SISTEAMNANCY/ROne/README.md

# ROne
Automated manual resuscitator prototype. To study the constraints , before thinking a use on a patient.
Prototype d'insufflateur "BAVU" automatisé. Pour étude des contraintes avant d'envisager une utilisation sur patient.
03/07/2020 : Le code du microcontrôleur de sécurité n'est pas commenté. Le bouton de silence alarme n'est pas encore  fonctionnel. Après modification d'un réglage de FR, I:E ou Vt, il faudrait invalider les alarmes jusqu'au cycle suivant pour éviter une alarme intempestive de débranchement patient.
