SISTEAMNANCY/ROne/ROne_logigramme_général.pdf

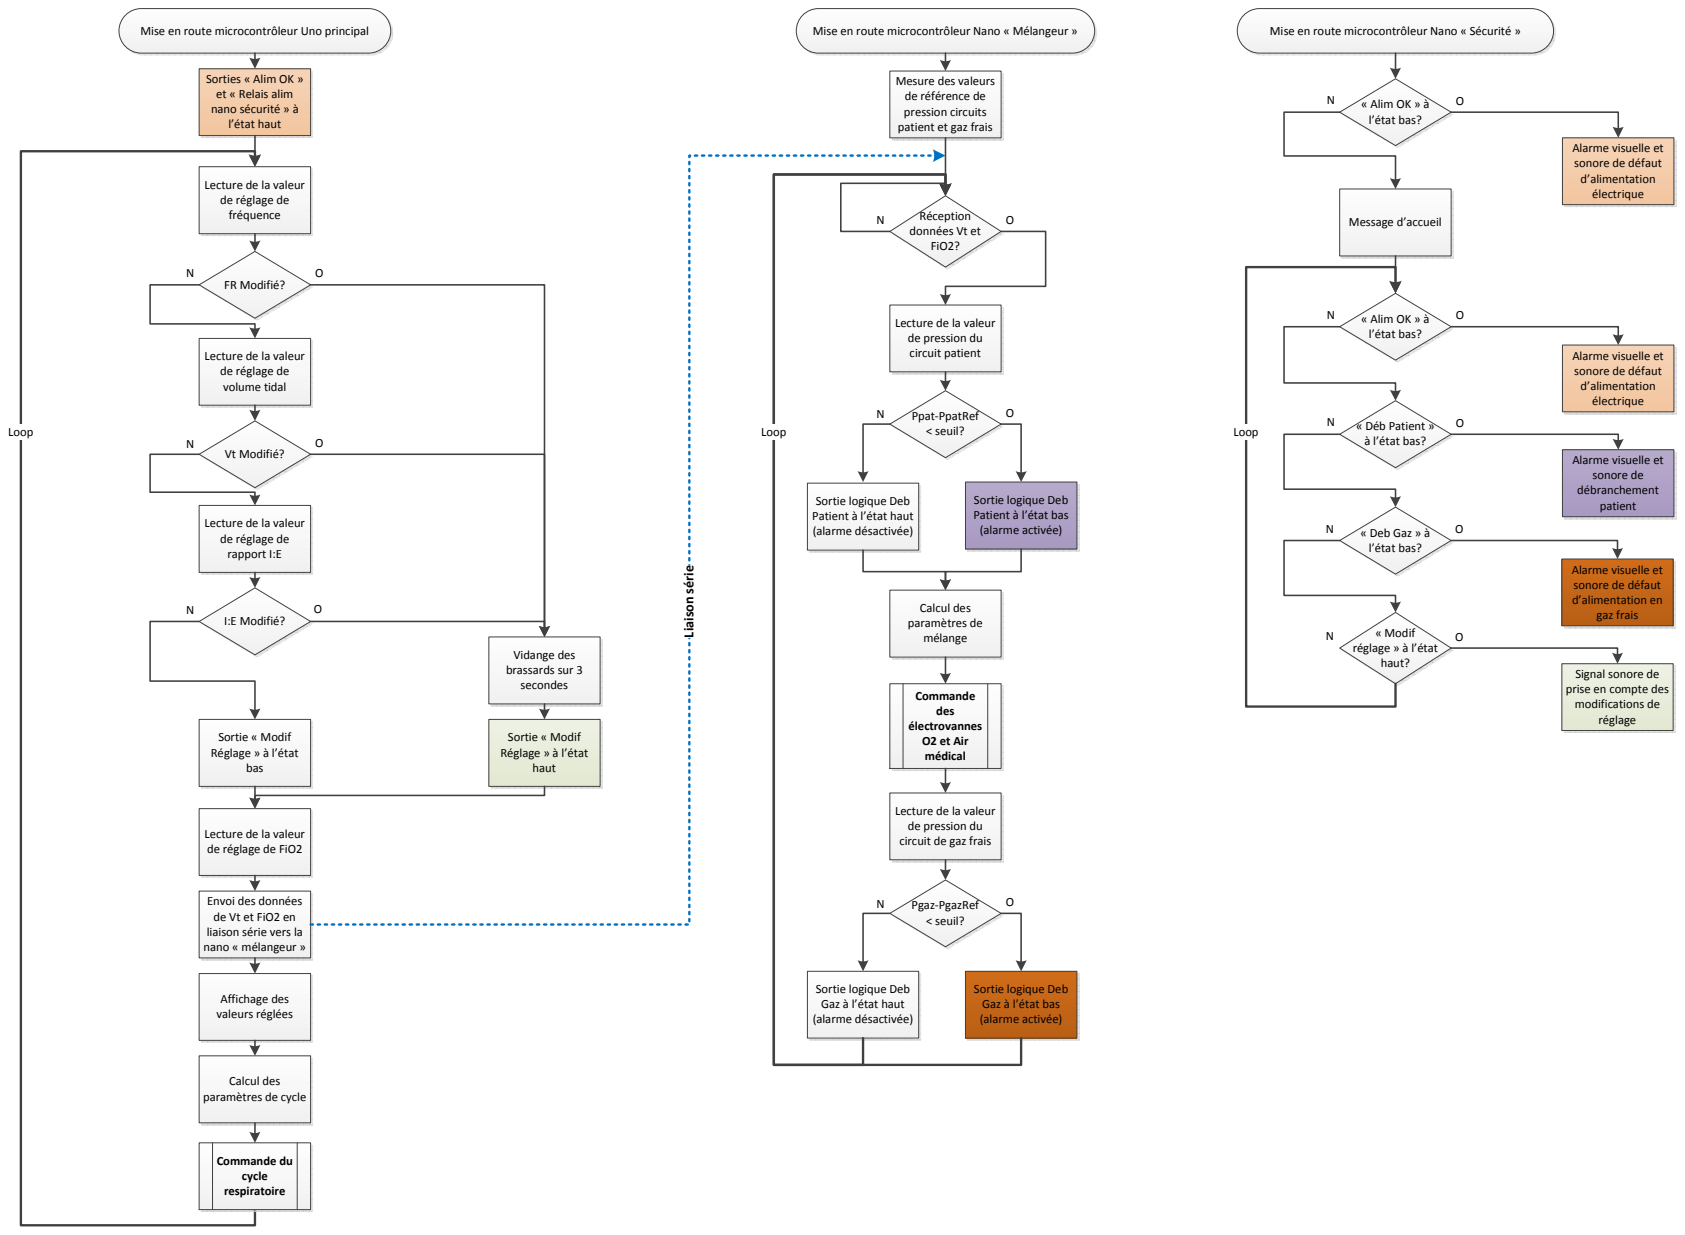
[picture p3: page 1]
FR Modifié?; Vt Modifié?; I:E Modifié?; Vidange des brassards sur 3 secondes; Affichage des valeurs réglées; Loop; Sortie « Modif Réglage » à l’état haut; Sortie « Modif Réglage » à l’état bas; Réception données Vt et FiO2?; Ppat-PpatRef < seuil?; Calcul des paramètres de mélange; Pgaz-PgazRef < seuil?; Message d’accueil; « Alim OK » à l’état bas?; « Déb Patient » à l’état bas?; « Deb Gaz » à l’état bas?; « Modif réglage » à l’état haut?; Liaison série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

Mise en route microcontrôleur Uno principal

Mise en route microcontrôleur Nano « Mélangeur »

Mise en route microcontrôleur Nano « Sécurité »

Sorties « Alim OK »
et « Relais alim
nano sécurité » à
l’état haut

Mesure des valeurs
de référence de
pression circuits
patient et gaz frais

Alarme visuelle et
sonore de défaut
d’alimentation
électrique

Lecture de la valeur
de réglage de
fréquence

de pression du
circuit patient

volume tidal

sonore de
débranchement
patient

Sortie logique Deb
Patient à l’état haut
(alarme désactivée)

Patient à l’état bas
(alarme activée)

rapport I:E

d’alimentation en
gaz frais

Signal sonore de
prise en compte des
modifications de
réglage

circuit de gaz frais

de réglage de FiO2

Envoi des données
de Vt et FiO2 en
liaison série vers la
nano « mélangeur »

Gaz à l’état haut

Gaz à l’état bas

Calcul des
paramètres de cycle
