SISTEAMNANCY/ROne/ROne_plan_berceau.PDF

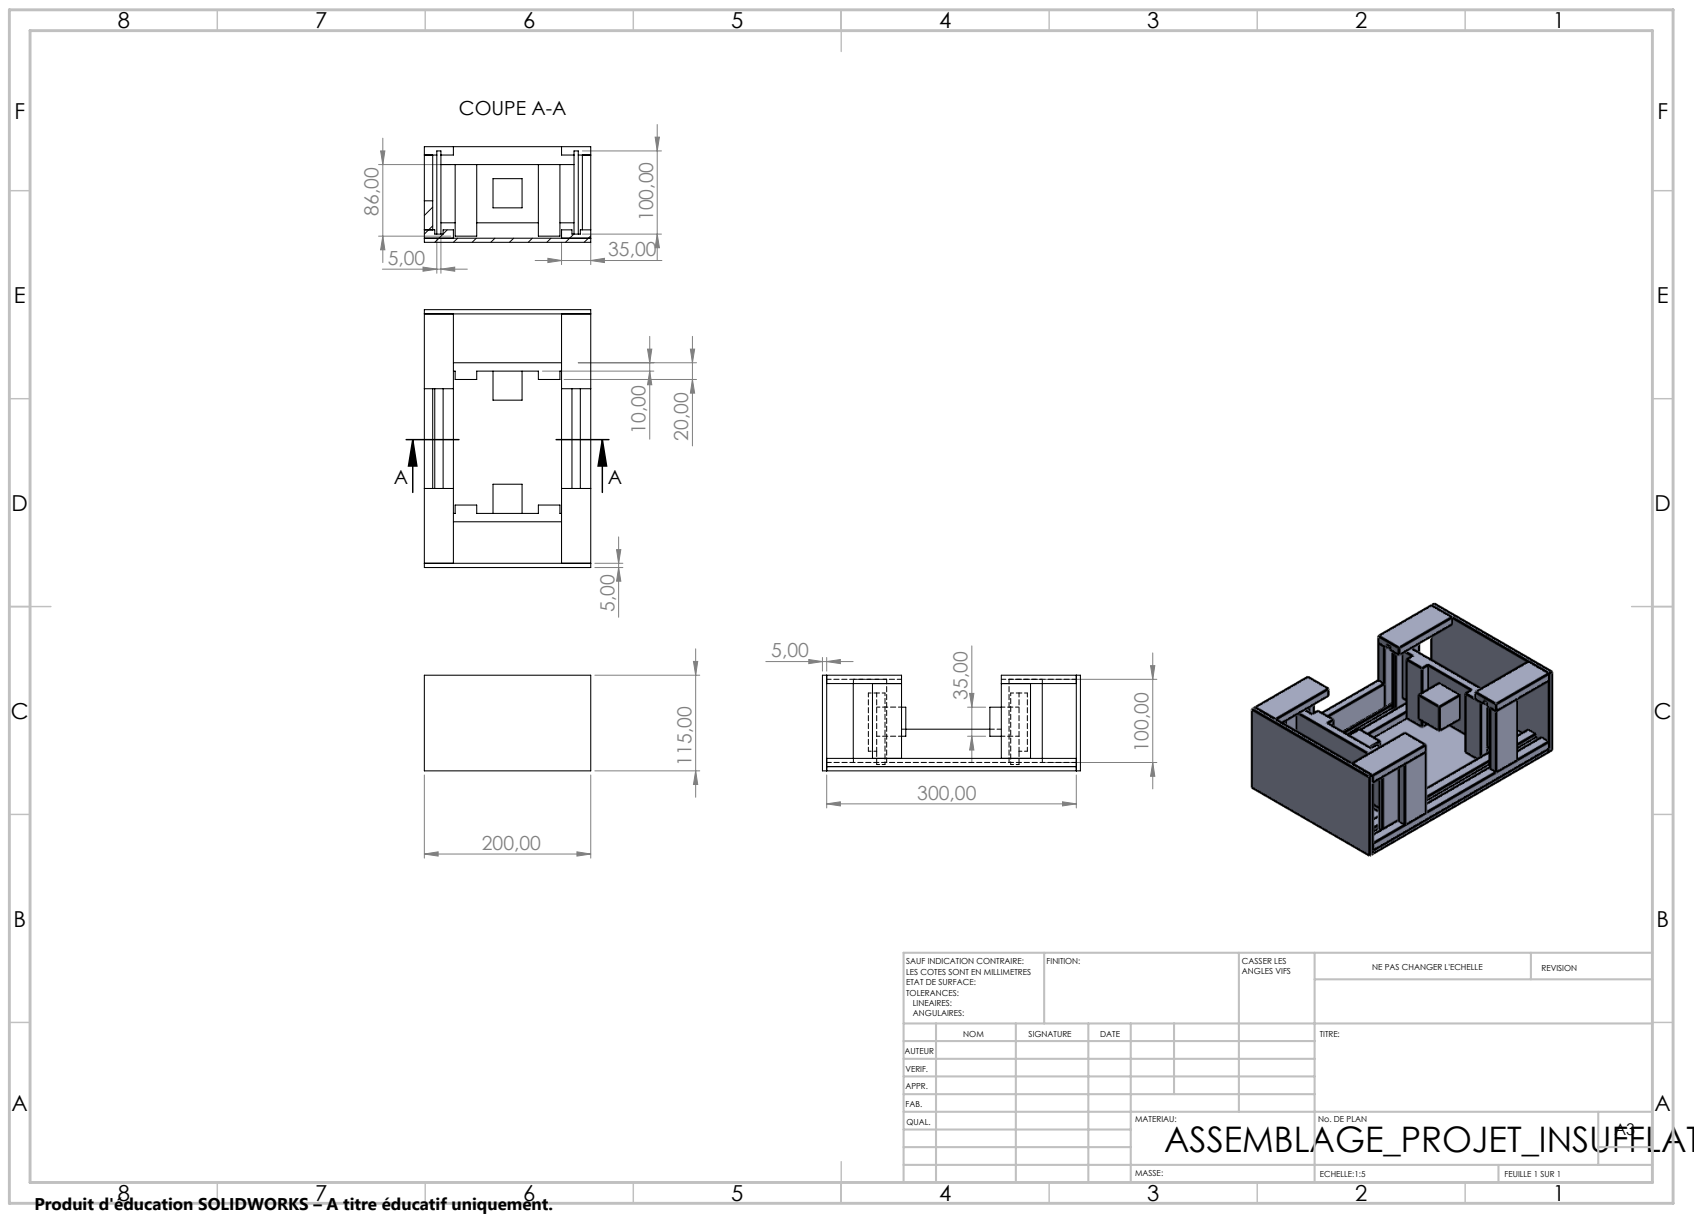
[picture p4: page 1]
COUPE A-A; FINITION:; CASSER LES; ANGLES VIFS; NE PAS CHANGER L'ECHELLE; REVISION; ECHELLE:1:5; FEUILLE 1 SUR 1

SAUF INDICATION CONTRAIRE:
LES COTES SONT EN MILLIMETRES
ETAT DE SURFACE:
TOLERANCES:
LINEAIRES:
ANGULAIRES:

NOM | SIGNATURE | DATE | | | | TITRE:

AUTEUR
VERIF.
APPR.
FAB.
QUAL. | | | | MATERIAU: | No. DE PLAN | A3

Produit d'éducation SOLIDWORKS – A titre éducatif uniquement.
