SISTEAMNANCY/ROne/ROne_schéma_câblage.pdf

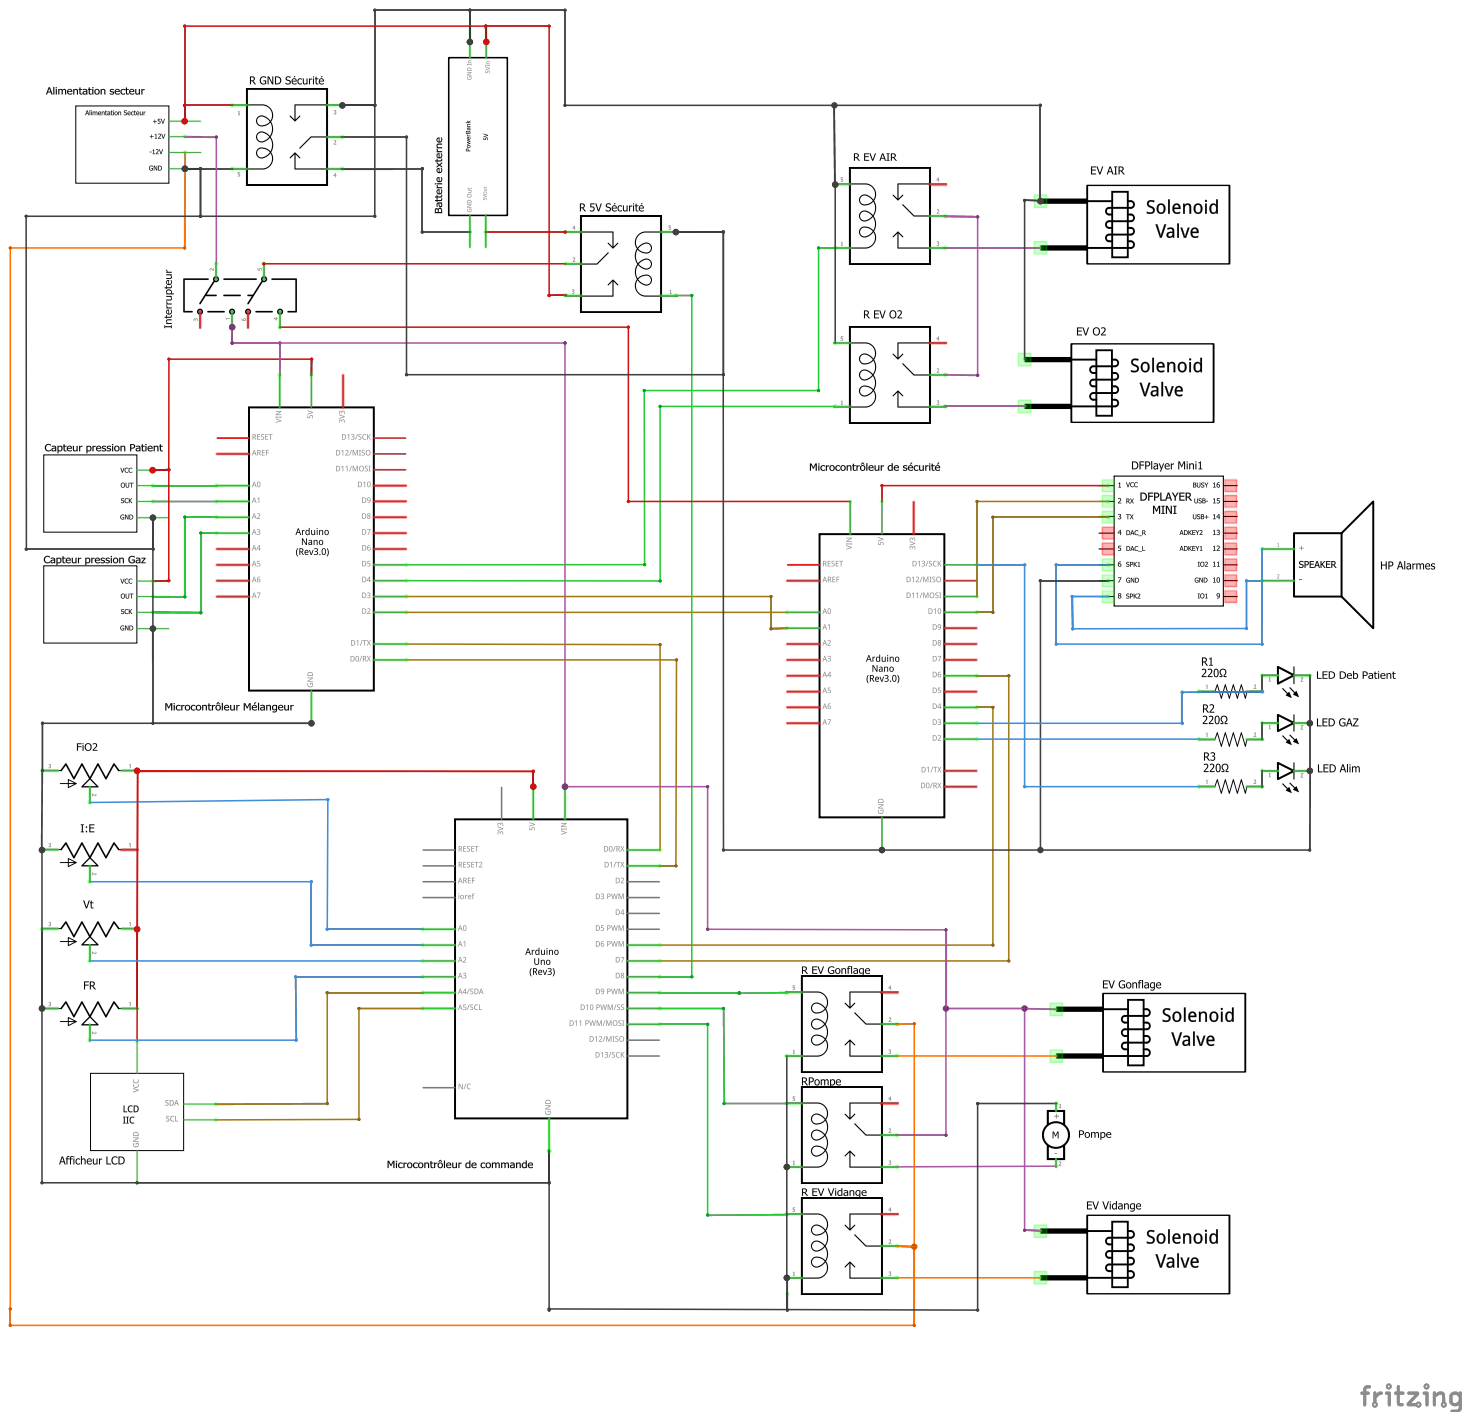
[picture p5: page 1]
